TTLES33/SpaceY-CzechRocketChallenge/2023/spacey_2023_reciever_arduino/spacey_2023_reciever.ino

//Include Libraries
#include <SPI.h>
#include <nRF24L01.h>
#include <RF24.h>

//create an RF24 object
RF24 radio(9, 8);  // CE, CSN

//address through which two modules communicate.
const byte address[6] = "00001";

void setup()
{
  while (!Serial);
    Serial.begin(9600);
  
  radio.begin();
  
  //set the address
  radio.openReadingPipe(0, address);

  radio.setChannel(82);


  //ZMENIT!!!!!!!!!!!!!!!!!!!!!!!!!!!!!!!!!!!!!!!!!!!!!!!!!!!!!!!!!!!
  radio.setPALevel(RF24_PA_MIN );
  

  radio.setDataRate(RF24_1MBPS);
  
  //Set module as receiver
  radio.startListening();
}

void loop()
{
  //Read the data if available in buffer
  if (radio.available())
  {
    char text[32] = {0};
    radio.read(&text, sizeof(text));
    Serial.println(text);
  }
}
